Kulicheg/pc98ps2/images/9d70a26ba2d9169ebc3224d822652c44.jpg

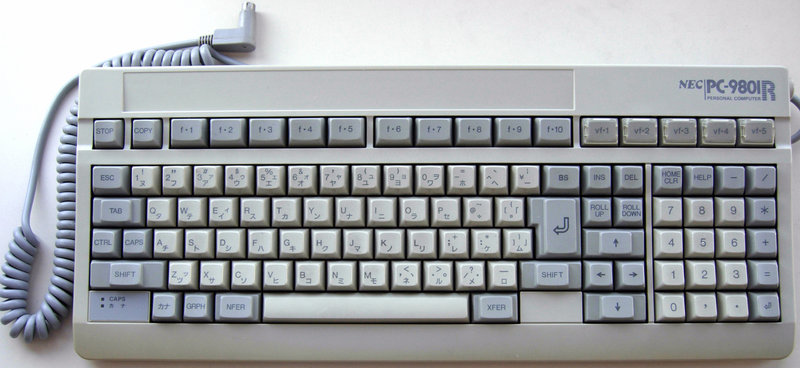
images/9d70a26ba2d9169ebc3224d822652c44.jpg
