Kulicheg/pc98ps2/images/photo_2026-11-08_21-04-24.jpg

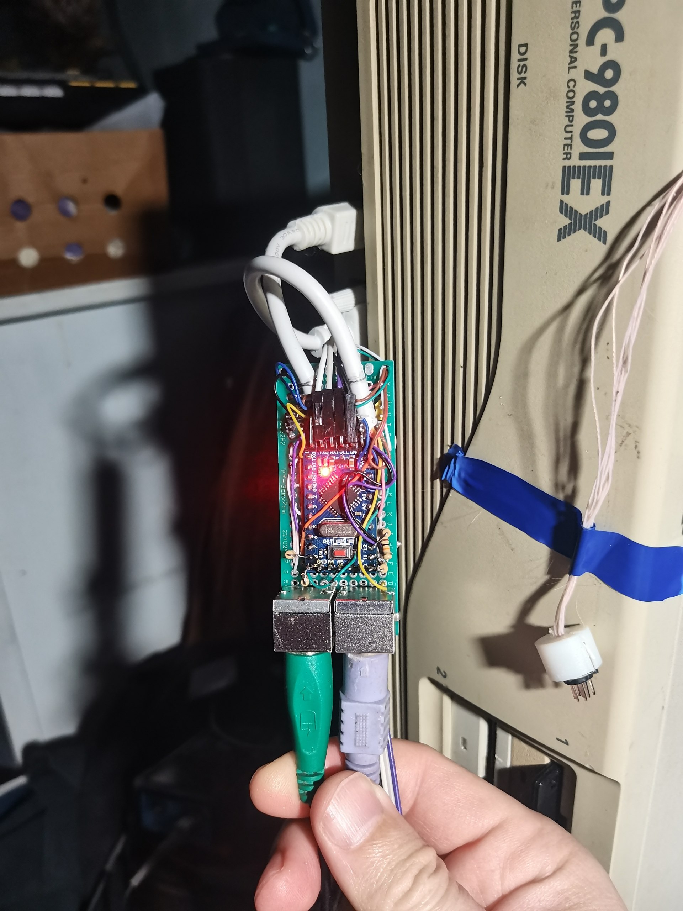
images/photo_2026-11-08_21-04-24.jpg
