Kulicheg/pc98ps2/README.md

Проект является компиляцией двух отдельных проектов

https://github.com/z4ke/ps2topc98 и https://github.com/tyama501/ps2busmouse98

# PC98dualPS2
Одна Arduino Nano одновременно переводит PS/2-клавиатуру в клавиатуру PC-98 и PS/2-мышь в шинную мышь PC-98.

Клавиатурные карты взяты из `ps2topc98` (zakernichny). Фазы квадратуры ? из `ps2busmouse98` (tyama501): линия либо прижата к земле, либо отпущена. Строба у шины мыши нет, опрашивать порт PC-98 не нужно. Clock есть у обеих PS/2, оба сидят на аппаратных прерываниях (D2 и D3).

Плата: Arduino Nano, ATmega328P, 5 В, 16 МГц.

## Питание

Nano кормить с пина **5V**, не с VIN. На VIN стоит стабилизатор, от 5 В PC-98 на нём останется слишком мало.

+5 В взять **только с одного** разъёма PC-98:

- либо mini-DIN-8 клавиатуры, пин 8
- либо DB9 мыши, пин 1

Второй +5 В не подключать. Иначе два выхода блока питания машины окажутся параллельно. Земли соединить все: оба разъёма PC-98 и оба PS/2.

Пока Nano сидит на USB для прошивки, кабель PC-98 снять. Иначе USB и PC-98 оба подадут 5 В.

+5 В на пины 4 обоих PS/2 ? с той же шины, что питает Nano.

## Провода

| Nano | Куда |
|---|---|
| 5V | +5 В выбранного разъёма PC-98 и пин 4 обоих PS/2 |
| GND | mini-DIN-8 пин 2, DB9 пин 9, пин 3 обоих PS/2 |
| D0 | не занимать, это RX UART |
| D1 | клавиатура PC-98, mini-DIN-8 пин 4 (RXD, данные в машину) |
| D2 | мышь PS/2, clock, mini-DIN-6 пин 5 |
| D3 | клавиатура PS/2, clock, mini-DIN-6 пин 5 |
| D4 | клавиатура PC-98, ~RTY, mini-DIN-8 пин 5 |
| D5 | не занимать. Рядом с D8 (XA), наводка на правую кнопку |
| D6 | клавиатура PC-98, ~RST, mini-DIN-8 пин 1 |
| D7 | клавиатура PC-98, ~RDY, mini-DIN-8 пин 3 |
| D8 | мышь PC-98, XA, DB9 пин 2 |
| D9 | мышь PC-98, XB, DB9 пин 3 |
| D10 | мышь PC-98, YA, DB9 пин 4 |
| D11 | мышь PC-98, YB, DB9 пин 5 |
| D12 | мышь PC-98, левая кнопка, DB9 пин 6 |
| D13 | не занимать. На нём светодиод платы, он не даст кнопке отпуститься |
| A0 | мышь PS/2, data, mini-DIN-6 пин 1 |
| A1 | клавиатура PS/2, data, mini-DIN-6 пин 1 |
| A2 | мышь PC-98, правая кнопка, DB9 пин 8 |
| A3-A5 | свободны |
| A6, A7 | только вход АЦП, не использовать |

DB9 пин 7 никуда не паять.

Если номера выдавлены на пластике разъёма, верить им. Рисунки ниже нужны, когда клейма нет.

## Резисторы 10 кОм, десять штук

Все на +5 В:

- PS/2 клавиатуры: clock и data
- PS/2 мыши: clock и data
- DB9: XA, XB, YA, YB, левая кнопка, правая кнопка

Шина и кнопки работают открытым коллектором. Nano умеет только прижать линию к земле. Отпускает её резистор. Внутренней подтяжки Nano на этих шести линиях нет специально.

## PS/2, два гнезда (клавиатура и мышь)

На переходнике гнёзда mini-DIN-6, в них вставляются клавиатура и мышь. Вид **в отверстия**, ключ экрана снизу.

Клавиатура:

```
        6 н.с.        5 clock -> D3
     4 +5V              3 GND
        2 н.с.        1 data  -> A1
             |ключ|
```

Мышь:

```
        6 н.с.        5 clock -> D2
     4 +5V              3 GND
        2 н.с.        1 data  -> A0
             |ключ|
```

Хвостовики пайки с обратной стороны гнезда ? зеркало этой картинки: лево и право меняются местами, верх остаётся верхом.

## Клавиатура PC-98, вилка mini-DIN-8

Вилка вставляется в гнездо на корпусе машины. Ранние PC-9801 используют большой DIN-8 с другой геометрией. Если кабель клавиатуры уже работает, разъём на стороне машины не перепаивать: перенести только концы на Nano по таблице ?что переехало? ниже.

Вид на **штырьки** вилки, ключ сверху:

```
       ___ ___
      /  |_|  \
     / 6  7  8 \
    | 3   4   5 |
     \_ 1   2 _/
       \_____/
```

| Пин | Сигнал | Nano |
|---|---|---|
| 1 | ~RST, машина сбрасывает клавиатуру | D6 |
| 2 | GND | GND |
| 3 | ~RDY, низкий = можно передавать байт | D7 |
| 4 | RXD, данные в машину, 19200 8O1 | D1 |
| 5 | ~RTY, низкий = повторить последний байт | D4 |
| 6 | не используется | |
| 7 | не используется | |
| 8 | +5 В, если питание берётся отсюда | 5V |

Вид на **хвостовики пайки** той же вилки (штырьки от себя, ключ сверху). Так же выглядит гнездо на корпусе PC-98, если смотреть в отверстия:

```
       ___ ___
      /  |_|  \
     / 8  7  6 \
    | 5   4   3 |
     \_ 2   1 _/
       \_____/
```

~RST, ~RDY и ~RTY активны низким уровнем. В простое Nano держит на них внутреннюю подтяжку, машине это не мешает: она сама тянет линию.

RTY и RDY ? разные провода. В старом скетче оба define смотрели на один пин, так хост не отличить.

## Мышь PC-98, вилка DB9

Вилка вставляется в гнездо мыши на машине. Вид на **штырьки**, широкий ряд сверху:

```
   1     2     3     4     5
     6     7     8     9
```

| Пин | Сигнал | Nano |
|---|---|---|
| 1 | +5 В. Не паять, если питание уже взято с клавиатуры | |
| 2 | XA | D8 |
| 3 | XB | D9 |
| 4 | YA | D10 |
| 5 | YB | D11 |
| 6 | левая кнопка | D12 |
| 7 | не паять | |
| 8 | правая кнопка | A2 |
| 9 | GND | GND |

Вид на **хвостовики пайки** (штырьки от себя, широкий ряд сверху):

```
   5     4     3     2     1
     9     8     7     6
```

Пока мышь стоит, линии не дергаются. Один шаг держится PHASE_US 500 мкс, константа в начале скетча. Если курсор все еще дергается, ее увеличить, если вяло - уменьшить.

## Что переехало со старой макетки клавиатуры

| Сигнал | Было | Стало |
|---|---|---|
| TX в PC-98 | D1 | D1 |
| clock клавиатуры PS/2 | D3 | D3 |
| data клавиатуры PS/2 | D2 | A1 |
| ~RST | D4 | D6 |
| ~RDY | D5 | D7 |
| ~RTY | тот же провод, что RDY | отдельный провод на D4 |

D2 больше не data клавиатуры. Это clock мыши.

## Прошивка

Arduino IDE, плата Arduino Nano, процессор ATmega328P. На клонах с CH340 часто нужен пункт Old Bootloader.

`DEBUG` в начале скетча по умолчанию закомментирован: D1 говорит с PC-98 на 19200 8O1.

Для проверки мыши на столе раскомментировать `#define DEBUG`, прошить, открыть монитор порта на **57600**. В этом режиме передача в клавиатурный порт PC-98 выключена, UART один. Строка пакета:

```
M 08 01 FF 00 x 1 y -1
```

Это сырые байты PS/2, потом уже обрезанные dx и dy, которые уйдут в квадратуру. `M skip` ? байт выброшен, пока ждём статус с битом 3. `K in` ? байт с клавиатуры, `K out` ? байт, который ушёл бы в PC-98.

Потом `DEBUG` снова закомментировать и прошить боевой вариант.

Мышь, которая не ответила на сброс, не вешает клавиатуру: в логе будет `mouse: no`, клавиатура работает.

Смена карты клавиатуры ? Pause Break, как в исходном ps2topc98.
