Kulicheg/pc98ps2/images/202313107-ca38b250-b138-4b20-9112-8ef252b5cdd0.png

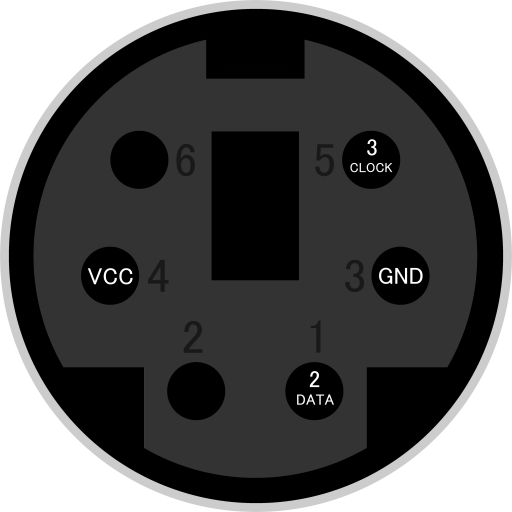
images/202313107-ca38b250-b138-4b20-9112-8ef252b5cdd0.png
