Kulicheg/pc98ps2/images/203018261-7aaf2aed-6e23-4cac-aa4c-19f40bf7b23e.png

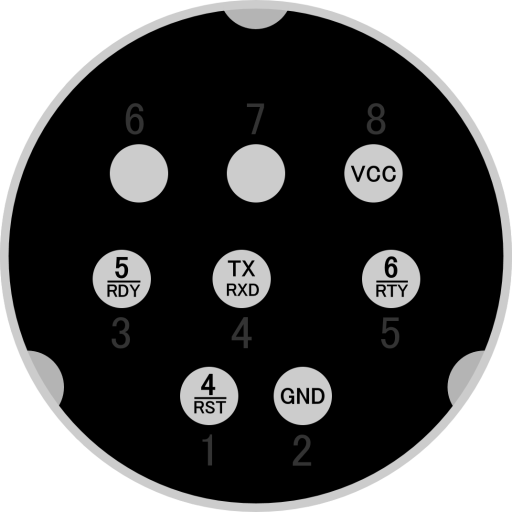
images/203018261-7aaf2aed-6e23-4cac-aa4c-19f40bf7b23e.png
