Kulicheg/pc98ps2/images/pc98_mouse_de9_pinout.jpg

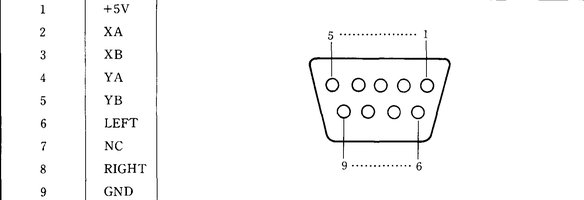
images/pc98_mouse_de9_pinout.jpg
