Kulicheg/pc98ps2/images/photo_2026-10-04_13-16-38.jpg

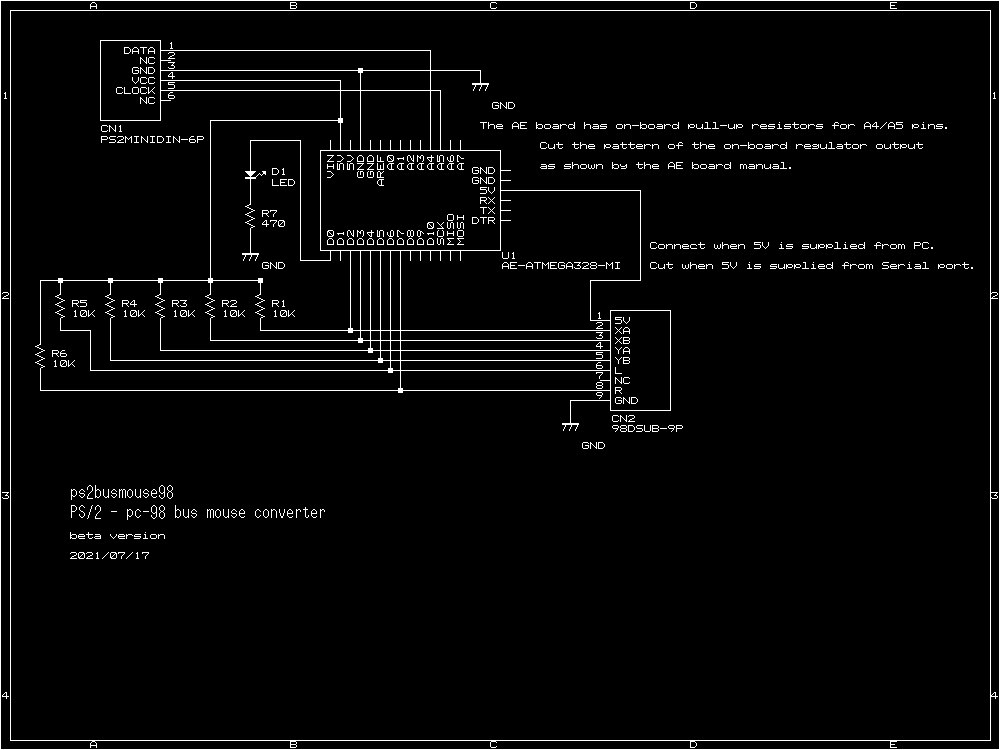
images/photo_2026-10-04_13-16-38.jpg
